maheshkee/juice-battle-1/docs/HANDOFF_2026_08_13_S024.md

# Juice Battle — Session Handoff
**Session:** S024 | **Date:** 2026-08-13 | **Duration:** Full day

This document enables the next Claude session to pick up exactly where S024 left off.
Read it fully before responding to anything. Do not touch code until you have confirmed
system state matches the "System State at Close" section.

---

## Session Identity

- **Session:** S024
- **Date:** 2026-08-13
- **Duration:** Full day session — audio, BLE reliability, chip replacement, calibration
- **Git tag:** stable-s024 (commit 4561501)
- **Branch:** main (monorepo at `/home/arduino/ArduinoApps/`)
- **Archived branch:** juice-battle-main (push target for juice-battle/ changes)

---

## System State at Close

**Both nodes connected and stable at session close.**

| Node | MAC | sigma | Status |
|---|-----|---|---|
| JB-0 | 70:AF:09:32:F3:C2 | 4.023g | Connected, stable |
| JB-1 | AC:27:6E:53:DC:4A | 3.728g | Connected, stable (new chip, replaced 2026-08-13) |

**Services:**
- `juice-battle.service` — active (game logic + dashboard)
- `juice-ble-scanner.service` — active (BLE scanner + TCP relay)

**Audio:**
- Working. pygame mixer at 48kHz, buffer 8192. fuzzy_horizon.mp3 looping.
- No underruns at session close.

**Display:**
- DP-1, 1920×1080, Arzopa 28" connected and active.

**Database:**
- `hub/data/jb.db` is active and contains today's test pours.
- **RESET BEFORE LIVE STALL:** `rm hub/data/jb.db` and restart juice-battle service.

**Hub network:**
- Arduino UNO Q (AQ3), IP: 192.168.88.25, user: arduino

---

## What Was Done This Session (S024)

### 1. Audio fix — mixer freq and buffer
**File:** `hub/main.py`
- Changed `pygame.mixer.init(frequency=44100)` → `frequency=48000`
- Changed `buffer=4096` → `buffer=8192`
- **Why:** fuzzy_horizon.mp3 is encoded at 48kHz. Wrong frequency caused SDL to resample,
  producing crackling. Small buffer caused underruns on the USB audio path.
- **Verified:** audio clean at session close, no underruns logged.

### 2. Per-node silence watchdog
**File:** `hub/ble_scanner.py`
- Added `_watchdog_per_node()` function, fired every 10s via `GLib.timeout_add_seconds`
- Threshold: `NODE_SILENCE_THRESHOLD_S` (30s) from `hub/config.py`
- Action: D-Bus `device.Disconnect()` — triggers `_properties_changed` → standard reconnect
- **Why:** global watchdog keys on `last_packet_time` from ANY node. If JB-0 healthy and
  JB-1 silent, global watchdog never fires. Per-node watchdog checks each independently.

### 3. Global watchdog threshold raised
**File:** `hub/config.py` and `hub/ble_scanner.py`
- `WATCHDOG_TIMEOUT_S`: 30s → 120s
- **Why:** with per-node watchdog at 30s, both could fire simultaneously — per-node triggers
  soft eviction + reconnect, global triggers hard adapter reset mid-reconnect. Cascade.
  120s global only fires when BOTH nodes silent for 2 minutes — genuine adapter fault.

### 4. Abort event — 4-second GATT blind window fix
**File:** `hub/ble_scanner.py`
- Replaced `time.sleep(4)` in connect worker with `abort_event.wait(timeout=4)`
- `abort_event = threading.Event()` stored in `_connect_abort_events[dev_path]`
- `_properties_changed` sets event when `Connected=False` fires during GATT window
- Worker wakes immediately, routes to `_on_connect_fail` — no phantom `_active_connections`
- **Why:** `time.sleep(4)` created a window where disconnect events had nothing to clean
  up, producing phantom connected state that prevented reconnect for 30s.

### 5. JB-1 chip replaced
- Old chip (MAC: 10:00:3B:CD:63:32) removed.
- New ESP32-C3 chip installed: **MAC AC:27:6E:53:DC:4A**
- `NODE_MAC_TABLE` in `firmware/node/juicebattle.ino` updated: old entry preserved as
  comment, new entry added.
- `KNOWN_NODES` in `hub/ble_scanner.py` updated to new MAC.
- Old BlueZ device entry removed: `bluetoothctl remove 10:00:3B:CD:63:32`
- Firmware reflashed to new chip. Calibration completed successfully.

### 6. Calibration polarity fix
**File:** `firmware/node/cal.cpp`
- Changed `if (raw_ref <= raw_zero)` → `if (raw_ref >= raw_zero)` (line 177)
- **Why:** `ads1232_read_raw()` negates result due to swapped INNA+/INNA- wires
  (`return -data`). Adding weight makes raw_ref MORE negative than raw_zero.
  Original guard always evaluated true — every weight step was rejected as "not above tare."

### 7. Calibration derived_cpg
**File:** `firmware/node/cal.cpp`
- Added `derived_cpg` block after `raw_refs[0]` is captured in Phase 2 loop
- Derives real counts/gram from first calibration point: `fabsf(raw_refs[0] - raw_zero) / ref_g[0]`
- Prints to Serial: `[CAL] derived counts/gram: X.XX (nominal was 54.00)`
- **Why:** NOMINAL_COUNTS_PER_GRAM=54 hardcoded from S002 measurement on different chip.
  New JB-1 chip reads ~98-101 counts/gram. Hardcoded constant was wrong by 1.8×.
- **Current state:** derived_cpg is printed only — not stored. CalResult has no
  `counts_per_gram` field. Deferred to S025.

### 8. STABILITY_SPREAD_THRESHOLD_G widened
**File:** `firmware/node/config.h`
- `STABILITY_SPREAD_THRESHOLD_G`: 25.0f → 50.0f
- **Why:** at 54 nominal but 98 real counts/gram, 25g × 54 = 1350 counts was too tight.
  Equivalent to only 13.8g at real chip sensitivity. `wait_for_stable()` was failing.
  50g × 54 = 2700 counts is safely above observed max spread of 1278 counts.

### 9. KNOWN_NODES updated
**File:** `hub/ble_scanner.py` (line 43-46)
- JB-1 MAC changed from `10:00:3B:CD:63:32` → `AC:27:6E:53:DC:4A`
- Comment added: `# new chip replaced 2026-08-13`

### 10. Git sync
- `juice_battle/` directory synced to main monorepo at `~/ArduinoApps/`
- Tag created: `stable-s024` at commit 4561501
- Archived: `git push origin HEAD:juice-battle-main`

### 11. Announcement MP3s backed up
- 7 ambient announcement MP3s backed up to `hub/static/sounds/backup_2026_08_13/`
- Texts reconstructed from memory for re-recording

---

## Open Issues — Priority Order

### 1. JB-1 Supervision Timeout — Firmware (CHUNK 2) — HIGH
**Status:** NOT DONE. Design confirmed, implementation pending.

**The problem:** Default NimBLE supervision timeout is 42 seconds. If hub disconnects
without `LL_TERMINATE_IND` (crash, cable pull), JB-1 stays in ghost-connected state for
42 seconds — invisible to `btmgmt find`, not advertising. Requires operator power cycle.

**Design (confirmed in S024):**
In `comms.cpp`, add `onSubscribe` callback to `NimBLEServerCallbacks`:
```cpp
void onSubscribe(NimBLECharacteristic* pChar, NimBLEConnInfo& connInfo, uint16_t subValue) {
    if (subValue == 1 || subValue == 2) {
        pServer->updateConnParams(connInfo.getConnHandle(), 24, 40, 0, 500);
        // minInterval=24 (30ms), maxInterval=40 (50ms), latency=0, timeout=500 (5s)
    }
}
```
After this, node self-detects ghost and resumes advertising within 5 seconds of hub disconnect.

**Risk of NOT fixing:** ghost connection can still strand the node for up to 42 seconds on
any unclean disconnect.

---

### 2. Watchdog False Positive on Fresh Connect — MEDIUM
**Status:** Identified, not fixed.

**The problem:** `_node_last_seen` persists across reconnects (Python dict, never cleared
on disconnect). If JB-1 was last seen at T=0, reconnects at T=35s, per-node watchdog fires
at T=30s interval and sees `silent_for = 35s > 30s` — fires eviction immediately after
connect, before the node has had a chance to send a packet.

**Fix (one line):**
In `_on_connect_success`, reset the timestamp:
```python
node_id = int(node_name.split('-')[1])
_node_last_seen[node_id] = _time.time()
```
This gives the node a fresh 30-second window from the moment connection is established.

---

### 3. ROUND_SIZE 2→10 Before Live Stall — CRITICAL IF GOING LIVE
**Status:** NOT DONE.
**File:** `hub/config.py`, single line change.
**Do this first thing if today is a live stall day.**
```python
ROUND_SIZE = 10  # was 2 (dev/testing)
```

---

### 4. v5 Dashboard — MEDIUM
**Status:** Designed, not built.

**Requirements captured in S024:**
- Jar fill logic: show jar filling as juice is poured IN, decrease as juice is taken out
  (current v4 logic is inverted — jar depletes as juice pours in)
- Banner crossfade: Dharanova↔IoT Summit should fade (not hard flip)
- Mascot: animated juice drop character, waves during idle
- Card flip VFX on round completion
- Ticker bar
- Crowd-wow sound effect on pour events

**Reference:** v4.html at `hub/templates/v4.html` is the current active dashboard.
v3.html preserved at `hub/templates/v3.html`.

---

### 5. Calibration — derived_cpg Not Stored in NVS — LOW
**Status:** Known gap, deferred.

**The problem:** `derived_cpg` is computed during calibration and printed to Serial but not
stored. `CalResult` struct (in `firmware/node/cal.h`) has no `counts_per_gram` field.
On boot, `sigma_tare_g` is still computed using `NOMINAL_COUNTS_PER_GRAM=54` (wrong for
new chip). Noise gate sigma_g is also wrong (fed by `ADS_NOMINAL_COUNTS_PER_GRAM=54`
in noise.cpp).

**Fix (two-part):**
1. Add `float counts_per_gram` to `CalResult` struct in `cal.h`
2. Add NVS key, save in `cal_save_to_nvs`, load in `cal_load_from_nvs`
3. Pass loaded value to noise.cpp for boot-time sigma computation

This makes `NOMINAL_COUNTS_PER_GRAM` truly unused after first calibration.

---

### 6. Validation Sweep Polarity Bug — LOW
**Status:** Identified, not fixed.

**The problem:** `cal_validate()` reports `measured=0.0g` for all weight points.
Root cause: `cal_to_grams()` uses `if (u <= 0.0f) return 0.0f` where `u = raw - cal.raw_zero`.
With negated ADC: `raw ≈ -100280`, `cal.raw_zero ≈ -49800`, so `u = -50480 < 0` → returns 0.

**The validation sweep is not blocking calibration correctness.** The piecewise model stored
in NVS is built from raw_refs directly — the polarity is consistent (all negated). The model
works correctly in game because `cal_to_grams` is only called from `scale.cpp` which feeds
`weight_engine`, not from validation.

**Fix:** In `cal_to_grams`, use `fabsf(u)` — or restructure to handle negative polarity.
Not urgent — defer to S025 cleanup pass.

---

### 7. Announcement Texts — Boss Recording — LOW
**Status:** MP3s backed up. Texts reconstructed.

7 ambient announcements need re-recording in the boss's voice. Texts were reconstructed
during S024 from memory. Source texts are available — coordinate with boss for recording
session before live stall.

---

### 8. Perfboard Build — Two Boards — PENDING PHYSICAL WORK
**Status:** Design complete from S023. Physical build pending.

26×31 hole dot-matrix layout designed. Two boards needed. Components list in HARDWARE_MANIFEST.md.
Build when physical access to soldering station is available.

---

## Working Contract (Carry Forward Always)

**Claude Chat = brain.** Architecture, diagnosis, decisions, prompts for CLI.
**Claude CLI = hands.** All file edits, code, bash execution, git.

**Evidence before code:**
Never touch code without reading the current state of the file first.
Read → diagnose → show diff → confirm → write. No exceptions.

**Git rules:**
- Never `git push origin main` from juice-battle context
- From `juice_battle/`: `git push origin HEAD:juice-battle-main` (archived branch)
- From monorepo root: `git push origin <branch>:main`

**Session opening ritual:**
1. Read HANDOFF document fully
2. Run health check: `sudo systemctl status juice-battle juice-ble-scanner`
3. Check both nodes connected in hub logs
4. Check git status: `git status && git log --oneline -5`
5. State system condition explicitly before doing anything

---

## Hardware Reference

| Component | Detail |
|---|---|
| Hub | Arduino UNO Q (AQ3), IP: 192.168.88.25, user: arduino |
| JB-0 | ESP32-C3, MAC 70:AF:09:32:F3:C2, sigma ~4g |
| JB-1 | ESP32-C3 (new chip, replaced 2026-08-13), MAC AC:27:6E:53:DC:4A, sigma ~3.7g |
| Display | Arzopa 28", DP-1, 1920×1080 |
| Audio | USB Audio Device (ALSA card name: "Device"), 48kHz |
| Load cell | CZL601 40kg, INNA+/INNA- swapped (ads1232_read_raw returns -data) |
| Calibration | 500g, 1000g, 5000g cast iron stones (government certified) |

---

## Key File Locations

| File | Purpose |
|---|---|
| `hub/ble_scanner.py` | BLE scanner, GATT central, TCP relay, watchdogs |
| `hub/config.py` | All hub configuration — ROUND_SIZE, thresholds, ports |
| `hub/main.py` | Game orchestrator, Flask-SocketIO, audio |
| `hub/templates/v4.html` | Active dashboard (current) |
| `hub/templates/v3.html` | Previous dashboard (preserved) |
| `firmware/node/juicebattle.ino` | Main firmware — NODE_MAC_TABLE, setup(), loop() |
| `firmware/node/cal.cpp` | Calibration — 3-point piecewise, NVS persistence |
| `firmware/node/config.h` | All firmware constants — thresholds, pin assignments |
| `firmware/node/comms.cpp` | BLE peripheral — NimBLE, advertising, GATT |
| `hub/data/jb.db` | SQLite game database — RESET before live stall |
| `hub/static/sounds/` | Audio files — announcements, background music |
| `hub/static/sounds/backup_2026_08_13/` | Backed-up original announcement MP3s |
| `docs/BLE_TRANSPORT_LESSONS_S024.md` | Full BLE stack reference — read before touching BLE |
| `SYSTEM_RUNBOOK.md` | Ops procedures — start/stop/reset |

---

## Rollback Points

| Tag | Commit | State |
|-----|---|---|
| `stable-s024` | 4561501 | Current known good — both nodes stable, all S024 fixes applied |
| `pre-bug1-fix` | (see git log) | Before blind window fix — useful if abort_event causes issues |
| `stable-s023` | 047e932 | Previous session stable |

---

## Calibration State

**JB-0:** Calibrated. NVS valid. Values from S003 original chip.
**JB-1:** Calibrated on new chip (2026-08-13). NVS valid. Confidence=1.000.
- raw_zero: ~-49800
- raw_500: ~-100280 (derived cpg ≈ 101 counts/gram)
- raw_1000: (captured during session)
- raw_5000: (captured during session)

If NVS is ever erased (esptool erase_flash), recalibration required with all three stones.
Calibration sequence: empty platform → 500g → remove → 1000g → remove → 5000g → remove.
Each step has 10-second settling countdown after Enter.

---

## Next Session Opening Prompt

Paste this verbatim at the start of S025:

---

```
JUICE BATTLE — S025 SESSION OPEN
Date: [fill in date]

Attached: HANDOFF_2026_08_13_S024.md

Read the handoff fully before responding to anything.

WORKING CONTRACT — non-negotiable:
- Claude Chat = brain: architecture, diagnosis, decisions
- Claude CLI = hands: all file edits, code, bash
- Evidence before code: read file → diagnose → show diff → confirm → write
- Never push to origin/main from juice-battle context
- Git push: git push origin HEAD:juice-battle-main (from juice_battle/)

SESSION OPENING RITUAL:
1. Confirm you have read the handoff document
2. Run: sudo systemctl status juice-battle juice-ble-scanner
3. Check hub logs for both nodes connected
4. Run: git status && git log --oneline -5
5. State system condition explicitly

TODAY'S PRIORITIES:
1. Health check — both services, both nodes, git status
2. [ ] JB-1 supervision timeout firmware fix (onSubscribe + updateConnParams, Chunk 2)
3. [ ] Watchdog false positive fix (_node_last_seen reset in _on_connect_success)
4. [ ] ROUND_SIZE 2→10 if going live today
5. [ ] v5 dashboard
6. [ ] Perfboard build (physical — requires soldering station)

Do not touch any file until you have confirmed system state.
State what you observe before proposing anything.
```

---

## Reference: BLE Adapter Reset Sequence

When the adapter is wedged or after any unclean shutdown — exact order, no shortcuts:

```bash
sudo hciconfig hci0 down          # error 95 on this platform = expected, ignore
sudo hciconfig hci0 up            # error 95 on this platform = expected, ignore
sudo systemctl restart bluetooth
sleep 15                          # mandatory on Qualcomm UART — do not reduce
sudo systemctl start juice-ble-scanner
```

## Reference: Pre-Stall Reset

```bash
sudo systemctl stop juice-battle
sudo systemctl stop juice-ble-scanner
rm /home/arduino/ArduinoApps/juice_battle/hub/data/jb.db
sudo systemctl start juice-ble-scanner
sleep 5
sudo systemctl start juice-battle
```

Then verify both nodes connected in logs before declaring ready.

## Reference: Manual BLE Scan

```bash
sudo systemctl stop juice-ble-scanner
sudo btmgmt find          # scans for ~10s, lists all BLE devices
sudo systemctl start juice-ble-scanner
```

Do NOT use `hcitool lescan` — does not work on this platform.
