maheshkee/juice-battle-1/(commit log)

2026-04-16 Arduino UNO Q BLE GATT dashboard with real-time WebUI control
2026-04-16 version one of the miniature PIL working with SR602 proximity sensor
2026-04-16 HC-SR501 PIR motion detector with WebUI dashboard on Arduino UNO Q
2026-04-17 feat: add motion-sensor-webui-ble v1.2 — PIR + web dashboard + BLE GATT
2026-04-17 v1.3: BLE scanner + multi-room dashboard + ESP32 remote sensor
2026-04-17 PIR including the BLE over the esp32 C3 module with HC501 sensor
2026-04-20 Add ble-webui-no-applab v1.0 - BLE GATT + MCU LED + Web dashboard, zero AppLab dependency
2026-04-20 Add ble-webui-no-applab v1.0 - BLE GATT + MCU LED + Web dashboard, zero AppLab
2026-04-22 feat: youtube-display v1.0
    - YouTube IFrame API streaming to external LCD via Chromium kiosk
    - WebUI brick (Socket.IO) for phone controller at port 7000
    - Phone UI: play/pause/resume/stop/volume controls
    - Splash home screen with live clock on LCD
    - launcher.sh: watches cmd.txt, manages Chromium transitions
    - XFCE autostart integration, LightDM auto-login
    - Supports youtube.com/watch?v= and youtube.com/shorts/ URLs
    - Admin backdoor at /admin.html
    - Auto-installs launcher script on first run
2026-04-22 docs: add setup.sh, deploy.sh, README.md
    Complete project documentation and automation scripts.
    Anyone cloning this repo can run bash setup.sh followed
    by bash deploy.sh to get a production-ready board.
2026-04-22 BLE hub display system for Arduino UNO Q
2026-04-22 BLE hub Flutter app for Arduino UNO Q
2026-04-22 created a folder for the arduino part and the flutter app
2026-04-23 feat: v1.2 BLE peripheral GATT server — phone connects and controls board
2026-04-23 feat: v1.2 complete — BLE peripheral, Flutter app, cursor fix, updated README and setup.sh
2026-04-24 feat: v1.3 Phase 2 — queue engine board side
    - queue_engine.py: YouTube queue state machine
    load/save queue.json, play/skip/replay/goto/pause/resume/stop
    auto-advance on video_ended, history logging
    - main.py: CMD:QUEUE_* routing to queue_engine
    video_ended socket event handler
    - splash.html: emit video_ended on IFrame ENDED event
2026-04-24 feat: v1.3 Phase 2+3 — queue engine + local storage + smooth transitions
    - Removed cmd.txt video bridge — all transitions now via Socket.IO
    - One Chromium instance stays alive, zero transition flash
    - splash.html: single-page app handles home/youtube/local switching
    - queue_engine.py: YouTube queue state machine with history
    - local_engine.py: local MP4 file management + USB import
    - launcher.sh: simplified — no cmd.txt loop, BT bridge intact
    - main.py: write_cmd() now dispatches Socket.IO events
2026-04-24 feat: v1.3 complete — queue engine + local storage + smooth transitions
    Board:
    - local_engine.py: local MP4 management + USB import
    - ble_gatt_serve.py: push_evt() for BLE EVT to phone
    - main.py: BLE EVT for queue/local events, pause/resume fixed
    - splash.html: single page app, /videos/ path fix
    - launcher.sh: simplified, BT bridge intact
    Flutter:
    - queue_item.dart, board_state.dart: queue + local state
    - ble_service.dart: BtDevice.connected, queue/local commands
    - queue_section.dart: builder UI + sent feedback
    - queue_controls.dart: full playback controls
    - local_section.dart: file browser + USB import
    - bt_audio_section.dart: paired list au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
2026-04-27 fix: handle Docker startup delay after hard power-off
    After unclean shutdown, App Lab container takes extra time to initialize.
    launcher.sh now waits 2 seconds after port 7000 is ready before launching
    Chromium, ensuring App Lab environment is fully initialized.
    This fixes ModuleNotFoundError that occurred when launcher tried to start
    the app before the Arduino module was available in the container.
2026-04-29 feat: app running, bt_manager stub, gas_monitor wired
2026-04-30 fix: exclude large core dump and socket files
2026-05-01 fixed watch later, scheduling list sharepreferences and storing in the board
2026-05-01 feat: weight pipeline working — D7/D6 bit-bang, Bridge.notify, cal=100.0f
    - Rewrote sketch.ino: raw bit-bang HX711 on D7/D6, no external library
    - Bridge.notify('weight_event') from loop() every 500ms
    - Removed weight_poll_loop from main.py (Bridge.call polling — wrong architecture)
    - Added Bridge.provide('weight_event') in main.py (correct API)
    - Fixed hx711_read_average(): filter RAW==-1, 0x7FFFFF, 0x800000
    - CALIBRATION_FACTOR = 100.0f (verified: 10g→10.4g, 20g→20.6g, 30g→32.4g)
    - Saved sketch_working_reference.ino as backup
    - Added docs/: hx711/, hardware/, uno_q/ reference folders
    - Updated CLAUDE.md and SKILL.md with HX711 learnings
2026-05-02 BT audio: BtDevicesScreen, BtAudioService, paired devices, XDG fix, display.html autoplay fix
2026-05-04 feat: experiments workspace + home-hub cleanup
    - Add experiments/: 001-freeze-test, 006-water-spoon-test, 007-cal,
    007-event-driven with app code, results, and conclusions
    - Add experiments/README.md: locked constants, architecture rules,
    summary of findings from each completed experiment
    - Add .gitignore: exclude .cache/, build artifacts (*.o *.elf *.bin etc.)
    - home-hub/CLAUDE.md: updated with calibration strategy and locked constants
    - home-hub/docs/: add HX711 flowchart SVG and load cell reference doc
    - home-hub/sketch/: move old HX711 library files to _backup/, remove
    sketch_working_reference.ino (superseded by experiments/007-event-driven)
    - hx711-hardware-test: add hardware vali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
2026-05-05 feat: hx711 003-noise-characterisation experiment app
    State-machine sketch: tare → cal → 200-sample noise measurement → delta detection.
    Key fixes applied: grams range filter, progress logging, float-only variance
    (double accumulator produces sum=0 on STM32U585), wait_ready 400ms timeout,
    Bridge yield delay(1) in noise+delta states.
2026-05-05 docs: add README for 003-noise-characterisation
    Documents purpose, threshold derivation, bugs found (double accumulator
    sum=0 on STM32U585), fixes applied, and deploy commands.
2026-05-05 docs: working mode, debugging rules, NEVER DO — all CLAUDE.md files
    Adds WORKING MODE, DEBUGGING RULES, NEVER DO sections to all CLAUDE.md
    files. Adds WORKING_CONTRACT.md, WORKING_MODE.md, SENSOR_CHARACTERISATION.md,
    and experiments/docs/ from today's session.
2026-05-05 feat: home-hub docs + deployed hx711 experiment app directories
    Adds home-hub SENSOR_CHARACTERISATION, WORKING_MODE, LEARNINGS_AND_INSIGHTS.
    Adds all deployed hx711 experiment app dirs (001 through 007).
2026-05-06 docs: add SENSOR_CHARACTERISATION for home-hub
2026-05-06 docs: add PLAN docs and 003 noise-characterisation results
    - experiments/docs/PLAN.md and home-hub/docs/PLAN.md: project plans added
    - experiments/hx711/003-noise-characterisation/RESULTS.md: filled with actual run data, summary, and platform finding (double broken on STM32U585)
2026-05-06 docs: add RESEARCH docs and update PLAN + SENSOR_CHARACTERISATION
    - PLAN.md and RESEARCH.md added at root
    - experiments/docs and home-hub/docs: RESEARCH.md added, PLAN.md and SENSOR_CHARACTERISATION.md updated
2026-05-06 feat: add experiment 004 modular refactor + clean 003 sketch
    - experiments/hx711/004-modular-refactor: full modular refactor of 003
    sketch split into hx711/tare/cal/noise/delta modules, sketch.ino
    is pure orchestrator, physical WAIT state detection, RESULTS PASS
    - experiments/hx711/003-noise-characterisation/sketch.ino: remove DBG
    diagnostic log and delay(1) yield calls
    [cal.cpp]
2026-05-12 playlist board sync with chunking, schedule offline sync, WL offline delete fix, save-on-change, schedule dates-first view, scroll/touch improvements
2026-05-12 playlist persist to board, chunked PLAYLIST/QUEUE/SCHEDULE transport, replay fix, clock toggle fix, schedule flag
2026-05-21 Refactor setup script for verification and dependencies
    Updated the setup script to verify the presence of wheels and typelibs instead of copying them. Added checks for dependencies and modified usage instructions.
2026-05-21 feat: shuffle/loop/repeat modes + persist modes per playlist
    - Add Shuffle, Loop, Repeat toggle chips in PlaylistDetailScreen
    - Persist modes per playlist in Playlist model (shuffle/loop/repeat fields)
    - Add updateModes() to PlaylistService — saves to SharedPreferences
    - Add queueLoopOn/Off, queueRepeatOn/Off to BleService
    - Fix mode command ordering — always send OFF before ON to prevent conflicts
    - Live queue sync when adding/removing videos during playback
    - Board: queue_loop and queue_repeat global flags
    - Board: QUEUE_LOOP_ON forces repeat=False, QUEUE_REPEAT_ON forces loop=False
    - Board: queue_set and queue_stop reset both flags
    - Board: on_video_ended respects repeat (replay curre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
2026-06-04 snapshot: STM32-era scaffold before ESP32 rewrite
2026-06-04 feat: ESP32 pivot — node/hub architecture, rewrite CLAUDE.md + docs, ingest 28 session files
2026-06-04 feat(E-000): first raw read passing - ESP32-C3 + HX711 + load cell confirmed - Wiring locked: GPIO4=DOUT GPIO3=SCK 3V3=VDD GND=GND - Load cell: Red=E+ Black=E- Green=A+ White=A- - E-000 gate PASSED: 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
2026-06-04 docs: add mental model theory, re-evaluation rules, update HW_VERIFY
    - Add L-006: complete measurement mental model (raw/tare/cal/noise/temp/sliding window)
    - Add L-007: re-evaluation rules — what re-derives per boot vs per setup change
    - List of STM32-era values confirmed VOID on ESP32
    - List of invariants that never change regardless of hardware
    - Update HW_VERIFY: Serial wait + 5s startup delay for native USB timing
    - Update SESSIONS.md LEARNINGS HANDOFF PROJECT_CONTEXT CLAUDE.md
2026-06-08 docs(E-001): E-001 PASSED - cal_factor derivation and grams output complete
    - Update CLAUDE.md current position to E-002 next
    - Update PROJECT_CONTEXT.md E-001 gate result
    - Append session 003 block to SESSIONS.md
    - Append L-008 L-009 to LEARNINGS_AND_INSIGHTS.md
    - Append ESP32 session 2 findings to RESEARCH.md
    - Add HANDOFF_2026_06_05_SESSION1_E001.md
2026-06-08 docs: add brainstorm learnings, fixed BLE architecture notes, and complete version roadmap
    - Add BRAINSTORM_LEARNINGS_MCU_TRANSPORT_AND_PRODUCT_ARCHITECTURE.md — first-principles capture of MCU communication and IoT product architecture session
    - Add ESP32_UNOQ_BLE_Architecture_Notes_FIXED.docx — corrected BLE architecture doc with seam contract, state model split, heartbeat interval fix, UNO Q BlueZ operational reality
    - Add GasCylinder_Version_Roadmap_Complete.docx — full version roadmap V1/V2/V3 plus v2.0 ML and v3.0 agent layers with 30-day V1 timeline
2026-06-08 - Add v1_lpg_monitor_30day_flow.html — interactive 30-day cylinder lifecycle visual
2026-06-08 feat(E-003): BLE transport PASSED + full session close
    - E003_ble_transport.ino: full boot sequence (stability/tare/noise/BLE/loop)
    - hub/e003_ble_test.py: self-provisioning, MAC cache, name filter, reconnect loop
    - hub/config.json: device config, MAC auto-populated on first run
    - hub/requirements.txt: bleak>=0.21.0
    - CLAUDE.md: updated to E-003 state, BLE transport, production noise values
    - PROJECT_CONTEXT.md: E-003 PASSED, hub files, transport updated
    - SESSIONS.md: session 003 block appended
    - LEARNINGS_AND_INSIGHTS.md: L-018 through L-031 appended
    - RESEARCH.md: section 13 BLE QRB2210 platform findings appended
    - docs/HANDOFF_2026_06_08_SESSION2_E003.md: session record created
    - docs/HA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
2026-06-12 feat(3E-001): 3-cell cal_factor PASSED + session close 2026-06-12
    3E-001 complete. cal_factor = 36.1 raw/g locked, linear 200g to 1800g
    confirmed across 3 stages. All session docs, learnings, and sketches added.
    - CLAUDE.md: Current State updated to 3E-001 PASSED (2026-06-12)
    - docs/SESSIONS.md: Session 003 2026-06-12 appended
    - docs/LEARNINGS_AND_INSIGHTS.md: L-ESP32-001 through L-ESP32-009 added
    - docs/RESEARCH.md: Section 13 (3-cell characterisation) added, Change Log updated
    - docs/PROJECT_CONTEXT.md: Current State 2026-06-12 appended
    - docs/ARCHITECTURE.md: new - modular node/hub structure document
    - docs/HANDOFF_2026_06_11_FINAL.md, HANDOFF_2026_06_12_FINAL*.md: session handoffs
    - doc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
2026-06-15 add whistle counter integration
    [mt19937-testset-1.csv, mt19937-testset-2.csv, pcg64-testset-1.csv, pcg64-testset-2.csv, pcg64dxsm-testset-1.csv, pcg64dxsm-testset-2.csv, philox-testset-1.csv, philox-testset-2.csv]
2026-06-15 docs(3E-002): lock noise floor - BLE on/off complete, HW_VERIFY_3CELL added - 3E-002 PASSED: noise_std_g=4.64g BLE-on, threshold=18.54g locked - BLE EMI penalty on 3-cell platform = ~1.0x (negligible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
2026-06-15 feat(3E-003): end-to-end BLE transport complete — hub deployed, demo achieved
    - 3E003_ble_transport_v1: 4-phase node sketch with PHASE_RUNNING BLE notify
    - hub/: complete App Lab app with setup.sh deploy.sh ble_subscriber.py index.html
    - CLAUDE.md: current position updated, hub rules added, stale references noted
    - SESSIONS.md: 2026-06-15 session block appended
    - LEARNINGS_AND_INSIGHTS.md: 5 new L-entries appended
    - RESEARCH.md: hub BLE and Docker patterns appended
    - PROJECT_CONTEXT.md: experiment status and hub state updated
    - HANDOFF_2026_06_15_SESSION1_3E003_hub_demo.md: created
2026-06-15 feat(3E-004): self-calibrating boot — accuracy verified ±7g across full range
    - Add 3E004_cal_and_run sketch: combined cal+run in one boot
    - Add E005_linearity sketch: linearity confirmed linear 700g-1700g
    - Fix tare_raw_g: use s2_mean (200-sample) not Phase 1 window mean
    - Append SESSIONS.md session 2026-06-16
    - Append LEARNINGS_AND_INSIGHTS.md L-entries: cross-boot cal, tare accuracy, linearity, min ref weight, self-cal architecture
    - Append RESEARCH.md 3-cell accuracy findings
    - Create HANDOFF_2026_06_16_SESSION2_3E004_accuracy.md
2026-06-16 docs: backlog audit + V1/V2/V3 architecture locked - 2026-06-16 session 2
    - Update PROJECT_CONTEXT.md: current state 2026-06-16, full backlog audit,
    V1/V2/V3 cold-start strategies, threshold derivations, BLE confirmed
    - Append Session 007 to SESSIONS.md: design session, no hardware
    - Append L-039 to L-043 to LEARNINGS_AND_INSIGHTS.md:
    threshold derivation principle, two-condition AND gate, cold-start
    unsolvability, delta immunity, conservative bias rule
    - Add HANDOFF_2026_06_16_SESSION2_DESIGN.md: next session briefing
    - Update home-hub/CLAUDE.md: current state, 3-cell platform, BLE transport
2026-06-16 add display mode switch (overlay/split) with persistence
2026-06-16 feat(node): 1A complete - gas_monitor_v1 modular sketch verified on hardware
    - Add node/gas_monitor_v1/ modular sketch (hx711/tare/noise/cal/weight/ble)
    - Add noise_recompute_sigma() for post-CAL gram-unit sigma correction
    - Add README.md with library dependencies (NimBLE-Arduino, ArduinoJson)
    - Add Known assumptions section to CLAUDE.md
    - Update CLAUDE.md PROJECT_CONTEXT.md current state
    - Append SESSIONS.md session 2 block
    - Append L-044 L-045 to LEARNINGS_AND_INSIGHTS.md
    - Append 2026-06-16 section to RESEARCH.md
    - Add HANDOFF_2026_06_16_SESSION2_1A_COMPLETE.md
    [cal.cpp]
2026-06-16 docs: add HANDOFF_2026_06_16_FINAL_3 — 1A complete, next=1B health module
2026-06-16 feat(node): add 1B health module - health.h health.cpp verified on hardware
    - Add node/gas_monitor_v1/health.h - HealthResult struct, health_check() 9-param declaration
    - Add node/gas_monitor_v1/health.cpp - pure function, 4 checks, bitmask, dpos diagnosis pattern
    - Update node/gas_monitor_v1/gas_monitor_v1.ino - health wired in STATE_RUNNING, 4 new globals
    - Update CLAUDE.md - current position 1B complete, known limitations added
    - Update docs/PROJECT_CONTEXT.md - 1B row complete, open questions 5-7 added
    - Append docs/SESSIONS.md - session 3 block
    - Append docs/LEARNINGS_AND_INSIGHTS.md - L-046 L-047 L-048
    - Append docs/RESEARCH.md - 2026-06-16 health verification section
    - Add docs/HANDOF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
2026-06-16 docs: add HANDOFF_2026_06_16_FINAL_4 — 1B complete, next=1C timing
2026-06-16 feat: 1C timing instrumentation — boot phase durations + tick_ms in [RUN]
2026-06-17 feat: 1D structured event journal — journal.h/journal.cpp, 9 event types, boot counter
2026-06-17 docs: session close 2026-06-17 — Node Layer 1 complete (1C+1D), next=3E-006B
    - Update CLAUDE.md current state to Node Layer 1 complete
    - Update PROJECT_CONTEXT.md — remove stale WiFi/STM32/Bridge references
    - Append SESSIONS.md session 003
    - Append LEARNINGS_AND_INSIGHTS.md L-049 through L-052
    - Append RESEARCH.md boot timing and journal findings
    - Add HANDOFF_2026_06_17_SESSION1_NODE_LAYER1_COMPLETE.md
    - Add HANDOFF_2026_06_17_FINAL_1.md
2026-06-17 docs: session close 2026-06-17 SESSION1 — Node Layer 1 complete, BLE pipeline verified
    - 1C timing instrumentation complete and verified
    - 1D structured event journal complete and verified
    - BLE transport end-to-end verified: node→hub→WebUI live
    - Fixed BlueZ UUID filter bug (use name filter instead)
    - Fixed cached device reconnect (check known devices on every scan)
    - Added passwordless sudo for dbus-bridge service
    - Appended L-049 through L-055 to LEARNINGS_AND_INSIGHTS.md
    - Appended BLE transport findings to RESEARCH.md
    - Appended Transport Observability deferred plan to PLAN.md
    - Updated SESSIONS.md session 003
    - Added HANDOFF_2026_06_17_SESSION1 and FINAL_1
2026-06-17 exp: 3E-006B complete — min detectable removal 20g; fix weight detector tick-to-tick→delay-line
    - 3E-006B experiment: min detectable removal = 20g (1 trial), hard floor = 10g
    - weight.cpp: replaced tick-to-tick delta with 20-tick delay-line detector + s_event_pending lockout
    - weight.h: added WeightEvent enum, event+delta fields to WeightResult, sigma_g to weight_update()
    - journal.cpp/h: journal_run() is now a pure reporter (5 args) — detection removed
    - hub/ble_subscriber.py: _check_known_devices() added for cached BlueZ devices, called at startup + reconnect
    - CLAUDE.md, PROJECT_CONTEXT.md, RESEARCH.md, SESSIONS.md, LEARNINGS updated for SESSION2
    - docs: HANDOFF_2026_06_17_FINAL_2 a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
2026-06-17 exp: 3E-007B complete — 0 false triggers 38min; disturbance analysis; HUB-001 HUB-002 backlog
    - 3E-007B false positive rate: 0 triggers in 38.4 min on static load. PASS
    - Disturbance analysis: silent tare shift on platform move. Two cases identified.
    - HUB-001: auto-retare after cylinder removal (requires node BLE write characteristic)
    - HUB-002: disturbance detection from heartbeat trend (requires Group 5 burn rate)
    - 190g slow drift observed on static load — flagged for 3E-009 characterisation
    - L-062 to L-065 appended to LEARNINGS
    - CLAUDE.md, PROJECT_CONTEXT.md, RESEARCH.md, SESSIONS.md updated for SESSION3
    - HANDOFF_2026_06_17_SESSION3.md created
    - HANDOFF_2026_06_17_FINAL_3.md upda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
2026-06-17 QR scan pairing, board name display, BT/location auto-enable on launch
2026-06-17 unique board ID, stop/resume advertising on connect/disconnect
2026-06-17 fix: noise WARN threshold for 3-cell platform, guard tare_variance stuck check
    noise.cpp: PASS gate 8g, WARN gate 15g (was calibrated for single-cell STM32)
    health.cpp: skip stuck check when tare_variance_raw==0.0f (TODO 1B-stuck)
    Both false positives fire on every healthy boot. Now only fire on real faults.
2026-06-18 fix: noise samples stored as raw counts, sigma_g computed once
    Storing grams in s_samples caused double-division when noise_recompute_sigma()
    ran after CAL. sigma shrank to 0.09g, threshold 0.36g, 200+ false WEIGHT_EVENTs.
    Samples now raw counts. Cal_factor applied exactly once at sigma conversion.
2026-06-18 docs: session close 2026-06-18 — 7 bugs fixed, BLE cmd char, TARE_WAIT
    SESSIONS.md: full session block with bug table, boot=35 values, features list.
    LEARNINGS.md: L-066–L-073 (docx section 11 remapped; file already had L-056–L-065).
    CLAUDE.md: current position, locked constants, TARE_WAIT boot timing, NEVER DO entry.
    PROJECT_CONTEXT.md: node features, locked values, hub status, next action.
2026-06-18 feat: dev/prod mode toggle, auto re-anchor, node status, timestamp fix
    db.py: db_get_dev_mode() / db_set_dev_mode() using existing config table.
    main.py: g_dev_mode flag (DB-persisted); DEV auto re-anchors every stable load,
    PROD locks once; on_node_connected/disconnected callbacks; set_dev_mode
    socket handler resets anchor state on switch; on_ui_connect sends node_status
    and dev_mode_ack on reconnect.
    ble_subscriber.py: on_connected/on_disconnected callbacks; MAC derived from
    D-Bus path; timestamp → human-readable strftime; subscribe fires on_connected.
    index.html: top bar with node dot + name + MAC + DEV/PROD toggle pill; card
    dims when node disconnected; badge uses muted colou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
2026-06-18 feat: PROD mode alert scaffolding, days remaining, calibrating placeholder
2026-06-18 fix: remove duplicate constant block — restore 350/2000/1000 as locked values
2026-06-18 docs: L-064 addendum — dynamic threshold transition pattern and gates
2026-06-18 fix: force BT power on at startup and in deploy — prevent adapter power loss
2026-06-18 docs: device setup guide, sudoers bootstrap, deploy prereq comment
2026-06-18 fix: require 3 consecutive stable readings before anchor — prevent premature anchor during placement
2026-06-19 player controls disabled when not in youtube mode, idle/clock button logic with nowPlaying guard
2026-06-22 BLE auth with shared key, single-phone exclusivity, unauthenticated device enforcer
2026-06-22 docs: session close 2026-06-18 full day — first working demo, hub dev mode, L-066 to L-070
    - CLAUDE.md: current state updated, hub constants added, position updated to boot=41
    - docs/SESSIONS.md: sessions 003 and 004 appended
    - docs/LEARNINGS_AND_INSIGHTS.md: L-066 through L-070 appended
    - docs/HANDOFF_2026_06_18_SESSION2_HUB_DEVMODE_DEMO.md: created
2026-06-22 docs: add Step 4 auto-start setup with correct app ID user:gas-cylinder-monitor/hub
2026-06-22 docs: session 5 handoff — thermal drift diagnosis, 3E-009/010 experiments, pending fixes
2026-06-22 feat(node): N1 journal SPIFFS persistence + hub anchor fix
    - journal.cpp: all 7 functions rewritten to write full lines to SPIFFS via journal_append()
    - journal.h: g_journal_file_bytes, g_transfer_pending, JOURNAL_TRANSFER_THRESHOLD_BYTES added
    - journal.cpp: journal_init() reads SPIFFS file size at boot for honest counter initialisation
    - journal.cpp: journal_tare_check() and journal_retare() added with proper sequence numbers
    - gas_monitor_v1.ino: 4 raw Serial.printf calls replaced with journal_tare_check/journal_retare
    - gas_monitor_v1.ino: g_transfer_pending stub check added in STATE_RUNNING
    - hub/main.py: ANCHOR_SPREAD_THRESHOLD_G=30.0 added as locked constant
    - hub/main.py: anchor spre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
2026-06-23 G4 complete: hub domain logic, state machine, modular reorg
    - domain.py: full G4 state machine (UNINSTALLED/BOOTSTRAP_ANCHOR/TRACKING/LOW_GAS),
    windowed anchor derivation, gas% calc, three bootstrap regimes, first-reading cross-check
    - log_transfer.py: extracted from main.py, owns full LOG_START/LOG_END pipeline
    - main.py: 267→113 lines, DEV mode deleted, orchestrator only
    - db.py: 4 new columns (gas_pct, gas_g, alert_level, cylinder_state), dead DEV functions removed
    - index.html: DEV/PROD toggle removed, calibrating-label wired to cylinder_state
    - config.json: G4 schema fields (brand, install_mode, cylinder_state, steel_g, etc.)
    - Docs: SESSIONS.md, LEARNINGS_AND_INSIGHTS.md (L-086–L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
2026-06-24 fix: SKIP_TARE+SET_CAL working, config.json path fixed, boot 27.5s
    - SKIP_TARE+SET_CAL verified on boot=21: boot time 27.5s (was 103.9s, 74% faster)
    - config.json path fixed: hub/config.json is correct (Docker mounts hub/ not hub/data/)
    - System stable 17h (session=16: 11:33 IST Jun23 → 04:19 IST Jun24)
    - hub_watchdog.py: 4 bugs fixed (hciconfig in Docker, READING_STALE_S=900, POST_ACTION_WAIT_S=120)
    - CLAUDE.md, SESSIONS.md, LEARNINGS (L-090/091/092), HANDOFF updated
2026-06-25 Restructure audio pipeline: split mic/whistle/voice into separate threads; replace OpenWakeWord with wakeword.eim (Marvin); add digits.eim for whistle target via voice; fix auth bypass for voice comm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
2026-06-25 feat(3E-005): water bowl anchor validation complete + WebUI additions
    - 3E-005 PASSED: full state machine UNINSTALLED→BOOTSTRAP_ANCHOR→TRACKING validated
    - Fix: separate REFILL_GROSS_MIN_G from ANCHOR_GROSS_MIN_G (infinite re-anchor bug)
    - Fix: data.pct → data.gas_pct field name mismatch in WebUI
    - Add: Install cylinder button to WebUI (state-gated, UNINSTALLED only)
    - Add: gas% display + progress bar to WebUI (TRACKING/LOW_GAS only)
    - Add: REMOVAL_GRACE_S=120s grace window before UNINSTALLED transition
    - Update: CLAUDE.md current state to boot=28, 3E-005 complete
    - Append: SESSIONS.md session 003 block
    - Append: LEARNINGS_AND_INSIGHTS.md four new entries
    - Add: HANDOFF_2026_06_25_SESS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
2026-06-26 docs: session 004 close — G5 G7 HUB-WATCHDOG complete
    - Update CLAUDE.md current state to G5+G7 complete
    - Append Session 004 block to SESSIONS.md
    - Append L-series learnings to LEARNINGS_AND_INSIGHTS.md
    - Create HANDOFF_2026_06_26_SESSION1_G5_G7_complete.md
    - 4 reference docx committed from session
2026-06-30 Add Moonshine voice transcription (tiny streaming model) replacing Whisper; switch main.py to voice_moonshine.py; add scipy high-pass filter for voice queue noise reduction; fix player command parsin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
2026-07-01 Remove scipy high-pass filter from mic thread - voice and whistle now share same raw audio
2026-07-02 docs: session 60 close — Fixes 1-3 deployed, 3E-009 attempt 2 ready
    Fix 1: READING_STALE_S 900→1800 (hub_watchdog.py)
    Fix 2: WiFi power save OFF permanently (systemd wifi-power-save-off.service)
    Fix 3: CMD_TARE protective check (ble_subscriber.py steel_g+tare_raw guard)
    3E-009 RCA confirmed: WCN3990 crash timing, node reboot downstream, wrong CMD_TARE
    CLAUDE.md updated to session 60 state (2026-07-01)
    Master reference + final handoff docs added
2026-07-02 feat(node+hub): Fix 4 reset reason logging, fresh tare, recovered reference docs
    - journal.cpp: add esp_reset_reason() to BOOT event (reset= field); add
    heap_caps_get_largest_free_block to HEARTBEAT (heap_max_block= field)
    - config.json: fresh tare_raw (-96218.4) from session 61 retare
    - docs: ACCOUNT_TRANSITION_PROTOCOL.md added
    - docs/reference: recovered ESP32-C3, HX711, ABX00162 datasheets + schematics
2026-07-02 session 61: Fix 4 verified, N-TARE-CHECK/threshold confirmed already done, G5/G7 status resolved, UNINSTALLED redesign drafted, session close protocol v2, PROJECT_CONTEXT/RESEARCH revived
    [readings.csv]
2026-07-08 Add wristband BLE char (a00b0004); moonshine local wheels; model to /app/models
2026-07-08 feat(session63): DHT22+OLS+CYLINDER_ABSENT+3E008-trial1
    - BLE seam extended to temp_c, DHT22 on GPIO5 with 10kΩ pull-up
    - Hub pipeline: db.py temp_c column, ble_subscriber, main.py threading
    - domain.py: CYLINDER_ABSENT state, set_uninstall_mode(), OLS burn rate,
    R2_MIN_THRESHOLD=0.3, SECONDS_PER_DAY=86400, BURN_RATE_WINDOW_DAYS=7.0
    - ble_subscriber.py: CMD_TARE guard fix (tare_raw only, removed steel_g — L-111)
    - index.html: CYLINDER_ABSENT arm, Uninstall button, Install guard
    - hub/analysis/3e008/: export_trial.py, fit_creep_thermal.py, README.md
    - setup.sh: scipy numpy added
    - 3E-009 attempt 3 declared PASS (68h22m, 99.78% coverage, 0 crashes)
    - 3E-008 Trial 1 run and analysed (α=29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
2026-07-08 fix: atomic config write + deferred tare_raw DUMP_LOG
    - _atomic_write_config(): extracted helper, tmp→fsync→rename pattern
    - crash recovery: .tmp loaded on startup if config.json missing
    - deferred secondary DUMP_LOG 25s after CMD_TARE to capture tare_raw
    after node SPIFFS write completes (~21s latency)
    - cmd_char cleared on disconnect to prevent stale BLE write path
    - _secondary_dump_timer cancelled on disconnect (belt-and-suspenders)
    - SKIP_TARE path unchanged, no firmware changes required
2026-07-08 docs: session 63 handoffs, analysis_package; gitignore runtime files
    - docs/HANDOFF_2026_07_07_FINAL_1.md
    - docs/HANDOFF_2026_07_08_FINAL_1.md
    - analysis_package/ (backtest scripts)
    - .gitignore: add hub/config.json, hub/logs/ (runtime state, not code)
    [3E-009-attempt3-full.csv, readings.csv]
2026-07-13 Add gas cylinder monitor integration: gas/ module, BLE subscriber piggybacking on existing scan, domain/db/watchdog, gas_update Socket.IO event, WebUI idle widget + overlay pill + split panel + setup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
2026-07-15 S002: noise.cpp complete - ads1232 HAL, Welford s, quality classification
    [config.h, juicebattle.ino]
2026-07-16 S002: ads1232 settling pulse fix, noise floor confirmed σ=6.23g GOOD
    [config.h, juicebattle.ino]
2026-07-16 docs(S002): session close — noise floor confirmed, architecture locked, cal.cpp next
    - Update HANDOFF_FINAL.md with S003 entry point
    - Add S002_architecture_phase1.md session record
    - Append L-001 through L-006 to LEARNINGS_AND_INSIGHTS.md
    - Append 2026-07-16 section to RESEARCH.md
    - Update docs with state machine dual-path detection
    - Firmware: ads1232 settling pulse fix, σ_live=6.23g confirmed
2026-07-16 Add gas cylinder uninstall flow
2026-07-16 feat(node): S003 cal + scale verified, polarity fix
    - Add cal.h cal.cpp: 3-point piecewise calibration, NVS persistent
    - Add scale.h scale.cpp: baseline capture, live read, noise clamp
    - Fix ads1232.cpp: negate raw value (green/white polarity bug)
    - Update config.h: CAL_MAX_ACCEPTABLE_SPREAD=0.08 from real measurement
    - Update juicebattle.ino: orchestrates noise+cal+scale+interactive test
    - Append S003 to SESSIONS.md, L-007 through L-012 to LEARNINGS
    - Update CLAUDE.md PROJECT_CONTEXT.md RESEARCH.md
    - Add HANDOFF_2026_07_16_S003_cal_scale_verified.md
    [cal.cpp, config.h, juicebattle.ino]
2026-07-17 S006: dynamic slope threshold, K_stop=8, min_delta filter, comms BLE layer
2026-07-17 docs(S005): stability state machine session close
    - Append S005 block to SESSIONS.md
    - Append L-009 L-010 L-011 L-012 to LEARNINGS_AND_INSIGHTS.md
    - Update CLAUDE.md current position
    - Add HANDOFF_2026_07_17_SESSION1_S005_stability.md
2026-07-17 docs(S006): session close — SESSIONS.md S006 entry, fresh HANDOFF_FINAL, TODO.md
2026-07-17 fix: remove foreign projects accidentally committed by CLI (S006 contamination)
    [3E-009-attempt3-full.csv, mt19937-testset-1.csv, mt19937-testset-2.csv, pcg64-testset-1.csv, pcg64-testset-2.csv, pcg64dxsm-testset-1.csv, pcg64dxsm-testset-2.csv, philox-testset-1.csv]
2026-07-17 docs(S006): session close — hardware verified, L-013/L-014/L-015, S007 scope in HANDOFF_FINAL
2026-07-20 S007: transport layer - BLE scanner systemd service, TCP NDJSON, consumer
    hub/ble_scanner.py: GLib event-driven passive BLE scan, D-Bus/BlueZ,
    TCP server :7001 (multi-client, threading), 30s watchdog, NDJSON emit.
    hub/transport.py: Docker-side consumer, callback registration, auto-reconnect.
    hub/config.py: all hub constants (BLE identity, ports, msg types, game params).
    hub/juice-ble-scanner.service: systemd unit, Restart=always, User=arduino.
    hub/setup.sh + deploy.sh: one-time setup and redeploy scripts.
    docs: S007 session record, S008 handoff, TODO updated.
2026-07-20 S007: GATT transport verified - hub connects to JB-0, HEARTBEAT flowing
2026-07-20 docs(S007): session close — CLAUDE.md updated, S008 scope set
2026-07-20 S008-D2: storage.py SQLite layer - 4 tables, Transport wired, verified
2026-07-20 S008-bonus: LED health indicators - GPIO8 node self-report, RGB LED1/2 hub
2026-07-21 S009: game.py glass counting, pour window, sigma-adaptive filter
2026-07-22 S011: pour-boundary redesign, disturbance detection, residue-kill, POUR_ACTIVE wiring
    - Fix production bug: POUR_WINDOW_S 8.0->20.0 (boss demo glass 4 missed at 10.44s gap)
    - Fix invisible logs: logging.basicConfig added to main.py
    - game.py: residue kill at glass-fire (partial=0 when new_glasses>0)
    - game.py: POUR_ACTIVE unconditional discard (boundary detector, not keep-alive)
    - game.py: disturbance detection + bounce suppression (BOUNCE_SETTLE_S=5s)
    - game.py: ANOMALY ceiling 450g + post-anomaly settling window (ANOMALY_SETTLE_S=30s)
    - game.py: preserve rule deleted (caused false glasses)
    - config.py: POUR_MAX_G_FRAC=3.0, BOUNCE_SETTLE_S=5.0, ANOMALY_SETTLE_S=30.0
    - main.py: wire POUR_ACT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
2026-07-29 S012b: JB-1 hardware bring-up complete — calibrated, BLE active, dual-node TCP verified
2026-07-29 S013: dual-node integration complete - VERIFIED
    - node_count=2 enabled in main.py
    - POUR_PRESERVE_FRAC removed (dead config since S011)
    - D04: jar-absent UI indicator (red pulse on ANOMALY, amber on BOUNCE)
    - node_status exposed in get_state() and dashboard payload
    - Dual-node concurrent glass counting verified: JB-0=5 JB-1=4
    - Conservation closes exactly: 1075.5g and 898.4g both account to zero
    - D10/D11 closed as phantom bugs
    Stable reference snapshot: both nodes end-to-end verified
    [config.h]
2026-07-30 S014: D01 accumulator restore + firmware Serial blocking fix + dashboard reconnect push
    [juicebattle.ino]
2026-07-30 S015a: Stage 0 complete — per-node reset + MAC-based node identity
    - storage.py: node_resets table, log_node_reset(), updated get_resumable_session() with LEFT JOIN + COALESCE gate
    - game.py: reset_node() method
    - dashboard.py: POST /reset/<node_id> route + reset button per jar card
    - firmware: NODE_ID resolved at boot from BT MAC via NODE_MAC_TABLE — identical binary for both nodes
    - Verified: T1-T5 all pass, D01 restore correct after per-node reset
    [config.h, juicebattle.ino]
2026-07-30 S015b: Stage 1 complete — _connect() threading fix
    - _connect() now spawns daemon thread, returns immediately to GLib loop
    - _connect_worker() runs device.Connect() + sleep(4) off the loop
    - _on_connect_success() and _on_connect_fail() post back via idle_add
    - Verified: JB-1 data uninterrupted during 23s JB-0 reconnect cycle
    - Both nodes reconnect concurrently in same second (was sequential 29s)
2026-07-30 S015c: Stage 2 complete — D03 ring buffer for TCP reconnect window
    - deque(maxlen=200) buffers all emitted events in ble_scanner.py
    - New TCP client receives buffer flush before joining live stream
    - for/else guard ensures dead socket during flush never added to clients
    - Verified: 168 events flushed on juice-battle restart, partial state
    correctly rebuilt, live pour immediately after reconnect scored correctly
    - Known gap: POUR_SETTLED in reconnect window may double-count if glass
    fires exactly during 5s TCP gap (DB + buffer both count it)
2026-07-30 S015 close: SESSIONS and HANDOFF updated
    S015 complete: per-node reset, threading fix, D03 ring buffer,
    MAC-based firmware identity. All three stages verified adversarially.
    Deferred: Stage 3 (BLE dropout pipeline), Stage 4 (D02 power loss),
    startup BLE discovery.
2026-07-30 S016 Stage 3: BLE dropout visibility pipeline
    - ble_scanner.py: emit NODE_DISCONNECTED at top of disconnect handler,
    NODE_CONNECTED after subscription confirmed
    - transport.py: NODE_DISCONNECTED/CONNECTED pass through (no change needed,
    dispatch is filter-based)
    - game.py: node_status dict alongside partial_g; on_node_disconnected sets
    status; on_node_connected resets partial_g and sets status; ble_status
    included in get_state() payload
    - main.py: registered on_node_disconnected and on_node_connected handlers
    with transport
    - dashboard.py: ble-badge-{n} pill per jar card; setBleStatus() toggled by
    500ms state poll and node_status_update socket event
    Verified: badge appears withi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
2026-08-04 feat(v2): jar graphics, live pour feed, dot strip, scrolling ticker
    - Add per-card jar fill SVG, liquid drops on glass count with 0.6s transition
    - Add live pour feed in centre column: glass, streak, node up/down events
    - Add dot strip per card, 12 pills filling in jar colour
    - Add bottom ticker bar: QR + branding static, scrolling stats marquee
    - Rework card layout to flex space-between, widen grid to 1fr/380px/1fr
    - Scale up persona name to 26px, score to 96px, character to 120px
    - Restyle RESET as a boxed button
    All existing character states, sounds, celebrations, and overlay preserved.
2026-08-05 feat(firmware): add hardware watchdog 10s timeout; track firmware source in git
2026-08-05 fix(firmware): update esp_task_wdt_init to IDF v5.x struct API
    [juicebattle.ino]
2026-08-05 fix(firmware): remove hardware watchdog — was causing JB-0 BLE drops every ~10s
    [juicebattle.ino]
2026-08-06 fix: transport host 127.0.0.1, splash→v3, dashboard v3 added
2026-08-06 fix(ble): periodic _check_known_devices poll every 10s — fixes JB-1 not discovered when both nodes on simultaneously
2026-08-06 feat: add speaker audio output via pygame
    - SoundPlayer class in game.py: non-blocking pygame.mixer,
    daemon thread per play, graceful fallback if no audio device
    - Triggers: glass.mp3 on scored pour, fanfare.mp3 on game over
    - setup.sh: install pygame, write ~/.asoundrc (USB card 1),
    verify USB adapter visible to ALSA at setup time
2026-08-06 feat: ambient audio — background music + voice announcements
    - ambient.py: AmbientPlayer with looping bansuri flute (pygame.mixer.music)
    and periodic TTS announcements every 30s (pygame.mixer.Sound, ducked music)
    - game.py: SoundPlayer switched from mixer.music to mixer.Sound so game
    sound effects no longer interrupt background music
    - main.py: AmbientPlayer wired in before dashboard.start()
    - setup.sh: pip install gtts, generate 7 ann_*.mp3 via gTTS (co.in accent),
    warn if flute.mp3 missing (manual Pixabay download required)
    - static/sounds: 7 announcement MP3s + flute.mp3 committed
    - .asoundrc: use card name 'Device' not number — stable across reboots
2026-08-06 feat: ambient audio — background music + voice announcements + USB hotplug recovery
    Audio stack:
    - ambient.py: AmbientPlayer loops bansuri flute (pygame.mixer.music),
    periodic TTS announcements every 30s (pygame.mixer.Sound, ducks music)
    - game.py: SoundPlayer uses mixer.Sound not mixer.music — game sounds
    no longer interrupt background music
    - main.py: AmbientPlayer wired before dashboard.start()
    Reliability:
    - juice-battle.service: SDL_AUDIODRIVER=alsa + AUDIODEV=hw:Device env vars
    so pygame always targets USB adapter by name not card number
    - juice-battle.service: TimeoutStopSec=5 for fast restart on USB replug
    - udev rule: /etc/udev/rules.d/99-juice-battle-audio.rules auto-res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
2026-08-06 fix: add udev hotplug rule and TimeoutStopSec to setup.sh
    - setup.sh installs /etc/udev/rules.d/99-juice-battle-audio.rules
    on fresh setup — auto-restarts juice-battle on USB audio replug
    - juice-battle.service: TimeoutStopSec=5, SDL_AUDIODRIVER=alsa,
    AUDIODEV=hw:Device for stable audio routing by name not card number
2026-08-06 fix: streak badge emoji and kiosk auto-reload on service restart
    - Replace HTML entity &#x1F525; with actual 🔥 emoji in streak badge
    (textContent does not parse HTML entities — direct char required)
    - Add wasDisconnected flag in v3 JS: socket disconnect sets it, reconnect
    triggers window.location.reload() so kiosk picks up fresh JS automatically
    after every service restart — no manual refresh needed on LCD screen
2026-08-06 fix: kiosk auto-reload on service restart + streak emoji fix
    - main.py: touch /tmp/jb_reload on startup
    - juice_battle_kiosk.sh: focus-keeper loop checks /tmp/jb_reload,
    sends Ctrl+R to Chromium window — forces page reload after restart
    - juice_battle_kiosk.sh: export DISPLAY=:0 in focus-keeper subshell
    so xdotool can find Chromium window from non-graphical context
    - dashboard.py v3: wasDisconnected + socket.io manager reconnect event
    for JS-side reload (works in browser, kiosk uses xdotool path)
    - dashboard.py v3: streak badge uses actual 🔥 emoji not HTML entity
    (textContent does not parse HTML entities)
2026-08-06 docs: BLE transport debug postmortem — root causes, fixes, diagnostic commands
2026-08-06 feat(rounds): auto round system — persist counter, TTS, overlay, 10s cooldown
    - config.py: ROUND_SIZE=10 (glasses per round, both jars combined)
    - storage.py: kv_store table + get_round_number() / set_round_number()
    - game.py: round tracking in __init__, freeze on cooldown, _trigger_round_end,
    _round_end_sequence (10s sleep → reset → increment → re-enable),
    set_ambient() wiring hook, round fields in get_state()
    - ambient.py: play_round_winner() and play_round_begin() with duck/restore pattern
    - dashboard.py: _push_loop detects round_in_progress transitions → emits
    round_over / round_begin; round overlay HTML/CSS/JS with 10s countdown bar;
    round_begin banner (2s flash); /res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
2026-08-06 feat(audio): replace flute with varanasi→anirudh ordered playlist
2026-08-06 fix(ble): ghost connection watchdog — remove+rediscover stuck nodes every 60s fix(firmware): supervision timeout 5s — NimBLE resets fast on ghost connection fix(audio): replace event-driven music loo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
    [comms.cpp, juicebattle.ino]
2026-08-06 feat(ui): round overlay in centre panel — scores visible during result
2026-08-06 feat(restart): clean shutdown flag — restart resets scores, crash resumes
    - storage.py: add generic get_kv() / set_kv() on kv_store table
    - main.py: register atexit handler that writes service_stopped_cleanly=true;
    convert SIGTERM → sys.exit(0) so atexit fires on systemctl stop/restart
    - game.py: on start(), check flag — if set, zero glass counts and consume flag;
    if missing (crash/power loss), resume previous scores unchanged
2026-08-07 fix(audio): increase pygame mixer buffer 512→4096 — eliminates ALSA underruns on ARM
2026-08-07 fix(ble): watchdog skips nodes mid-connection — prevents eviction during GATT discovery
2026-08-07 fix(ble): prevent connect storm — add to _connecting_nodes before idle_add not inside _connect
2026-08-07 fix(firmware): supervision timeout via onConnect updateConnParams — replaces broken setConnectionParams no-op
    [comms.cpp]
2026-08-07 fix(ble): restore connections — remove _connecting_nodes self-block in _connect, add InterfacesRemoved handler
2026-08-07 fix(audio): reduce background music volume 0.60→0.40 so announcements stand out
2026-08-07 fix(audio): reduce background music volume 0.40→0.20
2026-08-07 feat(session): session tier — slug, grace period, round results, session glass counter
    - storage: sessions.slug column, round_results table, kv_store;
    open_session() accepts slug; new methods: increment_session_glasses,
    get_session_glasses, record_round_result, get_session_wins,
    get_last_activity_time
    - game: slug generated per day (date-NNN, kv_store counter);
    grace period (4h) on crash resume — expired session → new session;
    increment_session_glasses on every counted glass;
    record_round_result on every ROUND_END;
    wrapper methods get_session_glasses / get_round_wins
2026-08-07 feat(dashboard): session_glasses ticker + round_wins per jar card
    - _build_payload: adds session_glasses (2s cache) and round_wins (5s cache)
    to every state push; all_time_served retained for marketing stats widget
    - v3 ticker: IOT ENTHUSIASTS SERVED now counts session_glasses (resets each
    session) instead of all_time_served — more relevant for stall visitors
    - v3 jar cards: wins-0/wins-1 elements show round win count below streak badge
    - v3 state handler: round_wins block updates both elements on every push
    - v3 CSS: .round-wins rule added alongside .streak-badge
2026-08-07 feat(dashboard): round number display + reset_rounds clears win history
    - _build_payload: adds round_number from game state to every push
    - v3 centre panel: round-label div shows current round above lead pill,
    updated on every state event
    - reset_rounds: calls storage.clear_round_results() and resets in-memory
    round_wins cache — ensures /reset_rounds starts a clean tournament
    - storage: clear_round_results() DELETEs round_results for given session
2026-08-07 fix(ble): _find_characteristic retry limit — break infinite GATT poll loop
    MAX_RETRIES=10 (30s total). On exhaustion: pops active_connections,
    discards connecting_nodes, schedules fresh reconnect in 5s via _reconnect_in.
    Retry counter carried via default-arg _retry across GLib timeout callbacks —
    no global state needed.
2026-08-07 feat(ambient): USB pendrive playlist detection at startup
    _detect_usb_playlist() scans /media/arduino/ for mounted volumes containing
    MP3 files. First volume with *.mp3 (sorted alphabetically) replaces the
    built-in playlist entirely. Falls back to AMBIENT_PLAYLIST if /media/arduino/
    is absent, unreadable, or contains no MP3s.
    self._playlist set in __init__ — start() and _music_loop() wiring follows.
2026-08-07 feat(ops): ops panel + audio controls + USB playlist wiring
    ambient.py:
    - add _detect_usb_playlist() — scans /media/arduino/ at startup,
    returns sorted absolute paths or built-in fallback
    - self._playlist + self._music_paused added to __init__
    - set_music_volume(), pause_music(), resume_music(), next_track()
    control methods (next_track uses self._playlist for USB support)
    dashboard.py:
    - __init__(game, storage=None, ambient=None) — ambient injected
    - self._ambient stored for audio route handlers
    - 10 new URL rules: /audio/{volume,pause,resume,next}, /ops,
    /new_session, /set_round, /force_round_end, /state
    - _OPS_HTML module-level constant — self-contained mobile ops panel
    with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
2026-08-07 fix(ambient): wire self._playlist into start() and _music_loop() — USB and fallback paths unified
2026-08-08 fix(audio): fix 3 bugs — ISO timestamp, AUDIODEV, hot-plug pendrive
    - storage.py: get_last_activity_time() crashed on ISO 8601 string from DB
    Fix: try float() first, fall back to datetime.fromisoformat().timestamp()
    - systemd: remove AUDIODEV=hw:Device — bypassed ALSA plug layer, caused
    sustained underruns and silence. SDL uses default via .asoundrc now.
    - ambient.py: add rescan_playlist() for udev hot-plug support
    - dashboard.py: add POST /audio/rescan_playlist endpoint
    - udev: 99-juice-pendrive.rules — auto mount/umount + rescan on plug/unplug
2026-08-12 fix(ble): robust transport — adapter reset, reconnect delay, remove conn params
    [comms.cpp, juicebattle.ino]
2026-08-12 audio: replace playlist with fuzzy_horizon.mp3, single track loop
2026-08-12 feat(ble): per-node silence watchdog — 30s threshold, forced eviction + discovery fallback
2026-08-13 feat(s024): blind-window fix, per-node watchdog, HCI recovery, cal polarity fix, new JB-1 chip MAC
    - hub: abort_event closes 4s GATT blind window race (bug1-fix)
    - hub: per-node silence watchdog 30s threshold, D-Bus Disconnect replaces bluetoothctl remove
    - hub: global watchdog raised to 120s, separates from per-node threshold
    - hub: JB-1 MAC updated to AC:27:6E:53:DC:4A (new ESP32-C3 chip)
    - firmware: cal polarity fix (raw_ref >= raw_zero for negated ADC)
    - firmware: derived counts/gram from first cal point — no more hardcoded nominal
    - firmware: STABILITY_SPREAD_THRESHOLD_G 25→50 for chip-agnostic cal
    - firmware: new chip MAC added to NODE_MAC_TABLE
    - audio: mixer freq 48kHz, buffer 81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
    [cal.cpp, config.h, juicebattle.ino]
2026-08-18 fix(firmware): cal_to_grams polarity fix — flip all four deltas for negated ADC
    [cal.cpp]
2026-08-19 feat(audio): simplify round-begin to fixed voice+ding, swap ambient lines
    - play_round_begin() no longer needs per-round-number files (1-10 +
    generic). Now plays a single ann_round_begin.mp3 ("Round begins",
    gTTS tld=co.in, matching existing voice pattern) followed by
    round_begin_bell.mp3 (synthesized ding). Scales to any ROUND_SIZE
    with zero pre-recorded per-round files.
    - Swapped 7 ambient announcement lines with boss-provided replacements
    (same filenames: namaste, grounded, come_taste, every_drop,
    enthusiasts, real_sensors, every_dot).
    - play_round_winner()/tie logic untouched.
    - 18 retired/pre-swap originals preserved in
    hub/static/sounds/backup_2026-08-19_round_begin_overh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
2026-08-19 fix(firmware): restore supervision-timeout fix dropped in 047e932
    Re-adds updateConnParams(...) (5s supervision timeout) to onConnect(),
    accidentally removed when MAC-based peer rejection was added on Aug 12.
    Coexists with peer-rejection logic. Not yet flashed to either node —
    manual step via Arduino IDE required next.
    [comms.cpp]
2026-08-24 feat(dashboard): add v5 route with logo swap, crossfade, bar removal
    - New hub/templates/v5.html, byte-identical copy of v4.html before edits
    - Swap Dharanova logo to TM version (dharanova_tm.jpg)
    - Replace 3D flip transition with opacity crossfade on logo panel
    - Remove 50/50 share progress bar (HTML+CSS+JS), keep player-card
    percentage displays intact
    - New /v5 route + _serve_v5 in dashboard.py, mirrors _serve_v4
    - v4.html and /v4 route completely unchanged
    - Verified in isolated test instance: route registration, HTTP 200
    on both routes, full Socket.IO handshake round-trip
    Claude-Session: https://claude.ai/code/session_01H25QTsj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
2026-09-01 fix(hub): thread hardcoded constants through config.py, add stable dashboard alias route
    - config.py: add ACTIVE_DASHBOARD_VERSION ("v5"); "/" now 302-redirects to it so the entry URL never goes stale on a version bump
    - config.py + ble_scanner.py: replace the literal 4 s GATT discovery wait with a named GATT_ABORT_TIMEOUT_S constant; fix the stale "sleep(4)" comment
    - config.py: correct the pygame mixer buffer comment (4096 -> 8192, 16x default)
    - config.py + ambient.py: move the ambient audio constants (AMBIENT_PLAYLIST, MUSIC_VOLUME, DUCKED_VOLUME, ANNOUNCE_INTERVAL_S, FADE_MS) into config.py; ambient.py imports them
    - dashboard.py: template glass_volume_g (config.GLASS_VOLUME_G) into the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
    [config.h]
2026-09-01 docs: correct stale IP, MAC, and version-path references
    - JB-1 MAC updated from the retired chip (10:00:3B:CD:63:32) to the current AC:27:6E:53:DC:4A across README.md, hub/README.md, hub/SYSTEM_RUNBOOK.md
    - hardcoded hub IP 192.168.88.25 replaced with AQ3.local in hub/README.md, hub/SYSTEM_RUNBOOK.md, docs/HARDWARE_MANIFEST.md (manifest keeps the last-known IP as a documented mDNS fallback)
    - versioned dashboard URLs (/v3, /v4) replaced with the stable / alias in README.md, hub/README.md, hub/SYSTEM_RUNBOOK.md, docs/juice_battle_stall_ops.html
    - README.md repo tree: drop the removed root HANDOFF_FINAL.md and SESSIONS.md entries
    - hub/README.md: inject_v3.py description moved to past tense (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
